Jakov4848/CustomMacroDeck/photos/pic1.jpeg

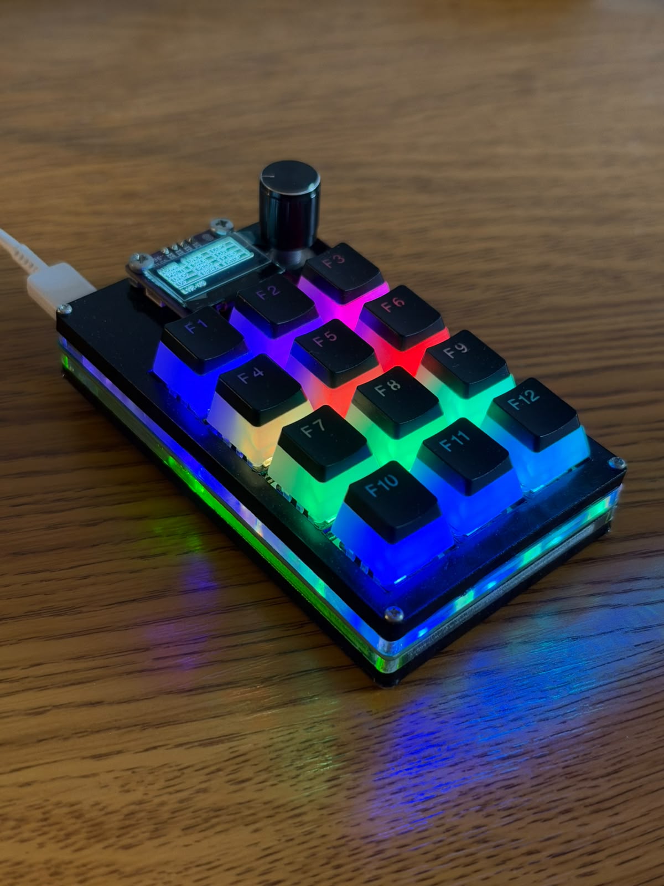
photos/pic1.jpeg
