Jakov4848/CustomMacroDeck/photos/pic2.jpeg

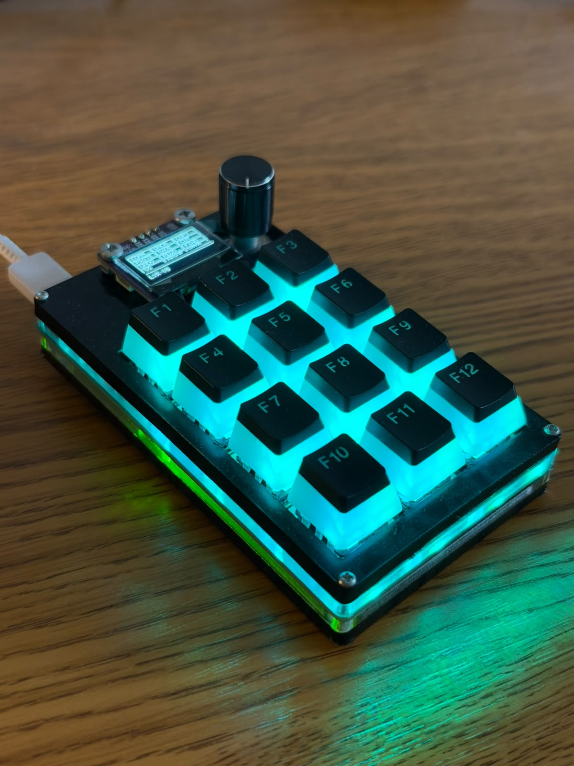
photos/pic2.jpeg
