Jakov4848/CustomMacroDeck/BOM/BOM.ods

PART NUMBER | DESCRIPTION | PACKAGE | DESIGNATOR | QUANTITY | PRICE | MANUFACTURER | URL
ATMEGA32U4-AU | ATmega32U4 mcu | QFP-44(10x10) | U1 | 1 | $ 6.93 | MICROCHIP | https://www.lcsc.com/product-detail/C44854.html?s_z=n_atmega32u4
TYPE-C 16PIN 2MD(073) | USB 2.0 Type‑C Receptacle, 16‑pin, SMT, with through‑hole tabs | SMD | J1 | 1 | $ 1.23 | SHOU HAN | https://www.lcsc.com/product-detail/C2765186.html | +
SSD1306 | Display OLED I2C 0.96 | 30 X 30 | J2 | 1 | €9,95 | SOLDERED | https://soldered.com/products/display-oled-i2c-white-0-96-ssd1306?_pos=1&_psq=ssd1&_ss=e&_v=1.0 | +
Conn_02x03_Top_Bottom | ICSP female header | THT | J3 | 1 |  |  |  | +
TS-1092S-B3D2-G | Tactile Switch | 6.1mmx3.6mm | SW1 | 1 |  |  |  | +
Cherry MX | Mechanical keyswitch | THT |  | 12 | €1,56 | HanElectricity | https://www.lcsc.com/product-detail/C49234236.html?s_z=n_red%2520switch
CPG151101S11-2 | Hot-Swap socket | SMD | SW2-13 | 12 |  | HanElectricity | https://www.lcsc.com/product-detail/C49352235.html?s_z=n_q_CPG151101S11
1N4148W | Diode Independent 75V 150mA Surface Mount | SOD-123 | D1-12 | 12 |  |  |  | +
ORH-B36G | Blue 460nm LED Indication | 0603LED | D13 | 1 |  |  |  | +
NQ03WAF1001T5E | 1kOhm Resistor(1%) | 0603R | R7 | 1 |  |  |  | +
0603WAF2201T5E | 2.2kOhm Resistor(1%) | 0603R | R8 R9 | 2 |  | $ 0.15 |  | +
0603WAF5101T5E | 5.1kOhm Resistor(1%) | 0603R | R1 R2 | 2 |  |  |  | +
FRC0603J103TS | 10kOhm Resistor(5%) | 0603R | R5 R6 | 2 |  |  |  | +
0603WAF4700T5E | 470Ω ±1% 100mW 0603 Thick Film Resistor | 0603R |  |  |  | UNI-ROYAL | https://www.lcsc.com/product-detail/C23179.html?s_z=n_q_0603WAF400T5E
0603WAF220JT5E | 22OHm Resistor(1%) | 0603R | R3 R4 | 2 | $ 0.13 | UNI-ROYAL | https://www.lcsc.com/product-detail/C23345.html?s_z=n_22Ohm%2520resistort
CGA0603XZR104K500JT | 100nF Capacitor(10%) | 0603C | C4 C5 C6 C8 | 6 |  |  |  | +
CGA0805X7R106K250MT | 10uF Capacitor(10%) | 0805C | C7 | 1 |  |  |  | +
CL10B105KA8NNNC | 1uF Capacitor(10%) | 0603C | C1 | 1 |  |  |  | +
CC0603JRNPO9BN220 | 22pF Capacitor(5%) | 0603C | C2 C3 | 2 | $ 0.28 | YAGEO | https://www.lcsc.com/product-detail/C105620.html?s_z=n_22pF
ABM3-16.000MHZ-D2Y-T | Crystal 16MHz ±20ppm 18pF 40Ω SMD5032-2P | SMD5032-2P | Y1 | 1 | $ 0.57 | ABRACON | https://www.lcsc.com/product-detail/C596861.html?s_z=n_Abracon%2520ABM3-16.000MHZ-D2Y-T
EC11E09244BS | Rotary Encoder Switch EC11 | THT | SW14 | 1 | $ 1.87 | ALPSALPINE | https://www.lcsc.com/product-detail/C470742.html?s_z=n_ec11 | +
MBR0520LT1G | Diode 20V 500mA Surface Mount SOD-123 | SOD-123 | F1 | 1 |  | onsemi | https://www.lcsc.com/product-detail/C23848.html
SMD1206P050TF | Polymeric PTC Resettable Fuse 6V 500mA Surface Mount 1206 | 1206D | D14 | 1 |  | PTTC(Polytronics Tech) | https://www.lcsc.com/product-detail/C2836286.html
