Jakov4848/CustomMacroDeck/BOM/LCSC_BOM.csv

LCSC Part Number | Manufacture Part Number | Manufacturer | Customer NO. | Package | Description | RoHS | Quantity | Unit Price(€) | Ext.Price(€) | Estimated lead time (business days) | Updated lead time | Date Code / Lot No. | Status
C49234236 | CPG151101D05 | HanElectricity |  | Through Hole | Red Switch 12V 45gf Through Hole Pushbutton Switches RoHS | YES | 15 | 0.0972 | 1.46 |  |  |  | -
C49352235 | CPG151101S11-2 | HanElectricity |  | - | 5,000 cycles 2 12V 3000gf Pushbutton Switches RoHS | YES | 50 | 0.0397 | 1.99 |  |  |  | -
C44854 | ATMEGA32U4-AU | MICROCHIP |  | QFP-44(10x10) | AVR 8 Bit 16MHz 26 QFP-44(10x10) Microcontrollers RoHS | YES | 4 | 7.0283 | 28.11 |  |  |  | -
C23179 | 0603WAF4700T5E | UNI-ROYAL |  | 0603 | 470Ω ±1% 100mW 0603 Thick Film Resistor | YES | 100 | 0.0015 | 0.15 |  |  |  | -
C23345 | 0603WAF220JT5E | UNI-ROYAL |  | 0603 | 22Ω ±1% 100mW 0603 Thick Film Resistor | YES | 100 | 0.0015 | 0.15 |  |  |  | -
C105620 | CC0603JRNPO9BN220 | YAGEO |  | 0603 | 22pF ±5% 50V Ceramic Capacitor NP0 0603 | YES | 100 | 0.0025 | 0.25 |  |  |  | -
C596861 | ABM3-16.000MHZ-D2Y-T | ABRACON |  | SMD5032-2P | Crystal 16MHz ±20ppm 18pF 40Ω SMD5032-2P | YES | 5 | 0.5294 | 2.65 |  |  |  | -
C470742 | EC11E09244BS | ALPSALPINE |  | Through Hole | Through Hole Encoders RoHS | YES | 2 | 1.6678 | 3.34 |  |  |  | -
C23848 | MBR0520LT1G | onsemi |  | SOD-123 | Diode 20V 500mA Surface Mount SOD-123 | YES | 5 |  |  |  |  |  | Inquiring
C2836286 | SMD1206P050TF | PTTC(Polytronics Tech) |  | 1206 | Polymeric PTC Resettable Fuse 6V 500mA Surface Mount 1206 | YES | 10 | 0.0644 | 0.64 |  |  |  | -
C965555 | WS2812B-2020 | Worldsemi |  | SMD,2.2x2mm | SMD,2.2x2mm LED Addressable, Specialty RoHS | YES | 20 |  |  |  |  |  | Inquiring
C49234235 | CPG151101D13 | HanElectricity |  | Through Hole | Blue Switch 12V 50gf Through Hole Pushbutton Switches RoHS | YES | 15 | 0.0933 | 1.40 |  |  |  | -
C49234237 | CPG151101D06 | HanElectricity |  | Through Hole | Brown Switch 12V 45gf Through Hole Pushbutton Switches RoHS | YES | 15 | 0.0977 | 1.47 |  |  |  | -
C41430893 | CPG151101S11-16 | HanElectricity |  | SMD,14.5x5.9mm | 5,000 cycles 2 12V 3000gf SMD,14.5x5.9mm Pushbutton Switches RoHS | YES | 20 | 0.0386 | 0.77 |  |  |  | -
