Jakov4848/CustomMacroDeck/photos/pcb_soldered1.jpeg

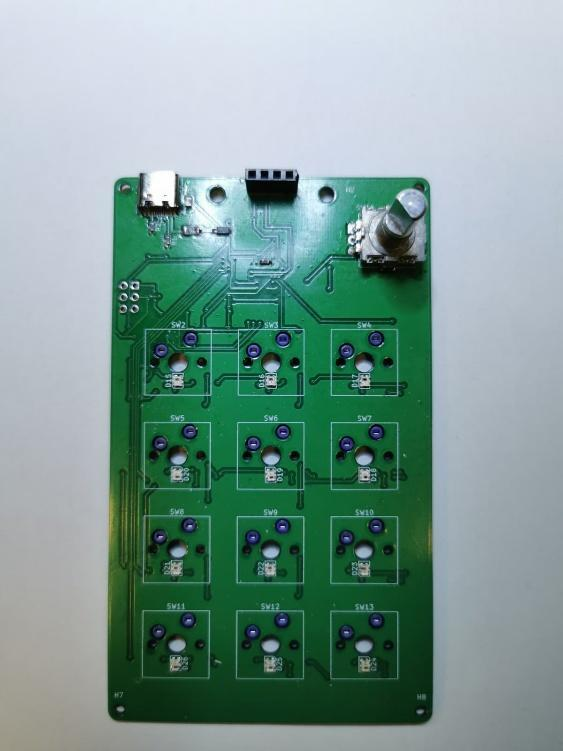
photos/pcb_soldered1.jpeg
