Jakov4848/CustomMacroDeck/photos/pcb_soldered2.png

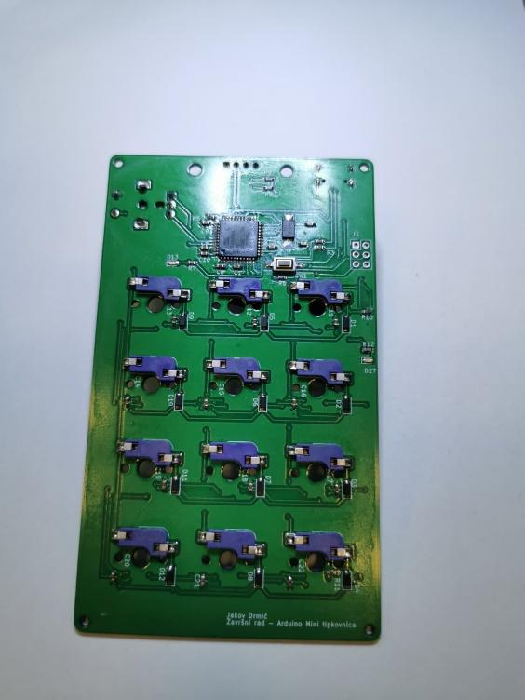
photos/pcb_soldered2.png
