Jakov4848/CustomMacroDeck/kicad_files/macropad.kicad_pcb

## KiCad design kicad_files/macropad.kicad_pcb (2026-10-21)

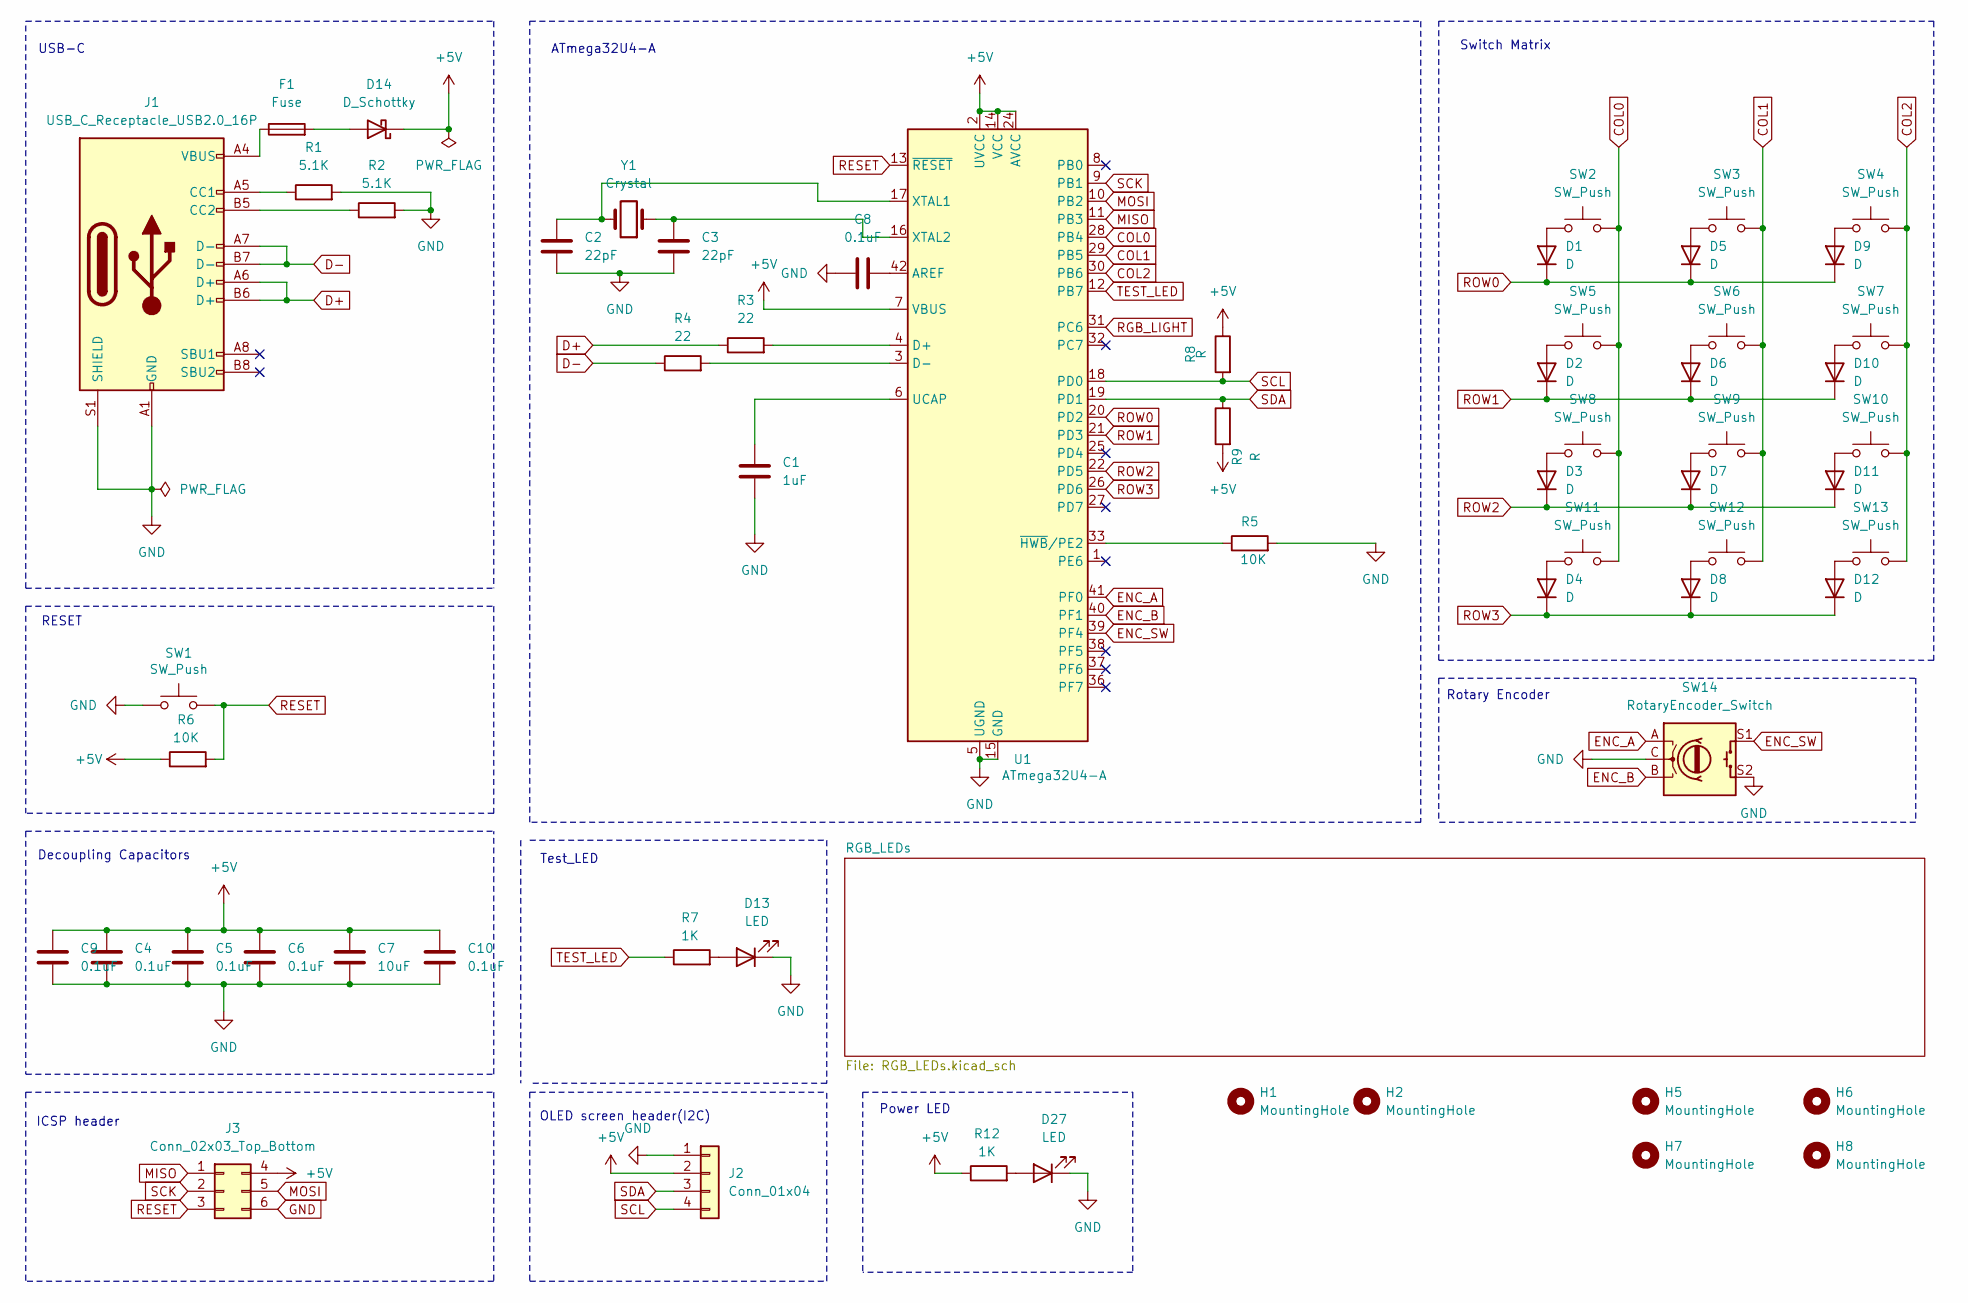
[picture p9: schematic macropad.kicad_sch]

Parts:
C1: 1uF; C_0603_1608Metric_Pad1.08x0.95mm_HandSolder
C2, C3: 22pF; C_0603_1608Metric_Pad1.08x0.95mm_HandSolder
C4, C5, C6, C8, C9, C10: 0.1uF; C_0603_1608Metric_Pad1.08x0.95mm_HandSolder
C7: 10uF; C_0805_2012Metric_Pad1.18x1.45mm_HandSolder
D1, D2, D3, D4, D5, D6, D7, D8, D9, D10, D11, D12: D; D_SOD-123
D13, D27: LED; LED_0603_1608Metric_Pad1.05x0.95mm_HandSolder
D14: D_Schottky; D_SOD-123
F1: Fuse; Fuse_1206_3216Metric_Pad1.42x1.75mm_HandSolder
H1, H2: MountingHole; MountingHole_3.2mm_M3
H5, H6, H7, H8: MountingHole; MountingHole_2.2mm_M2
J1: USB_C_Receptacle_USB2.0_16P; USB_C_Receptacle_HRO_TYPE-C-31-M-12
J2: Conn_01x04; PinSocket_1x04_P2.54mm_Vertical
J3: Conn_02x03_Top_Bottom; PinHeader_2x03_P2.54mm_Vertical
R1, R2: 5.1K; R_0603_1608Metric_Pad0.98x0.95mm_HandSolder
R3, R4: 22; R_0603_1608Metric_Pad0.98x0.95mm_HandSolder
R5, R6: 10K; R_0603_1608Metric_Pad0.98x0.95mm_HandSolder
R7, R12: 1K; R_0603_1608Metric_Pad0.98x0.95mm_HandSolder
R8, R9: R; R_0603_1608Metric_Pad0.98x0.95mm_HandSolder
SW1: SW_Push; SW_SPST_CK_RS282G05A3
SW2, SW3, SW4, SW5, SW6, SW7, SW8, SW9, SW10, SW11, SW12, SW13: SW_Push; SW_Hotswap_Kailh_MX_1.00u
SW14: RotaryEncoder_Switch; RotaryEncoder_Alps_EC11E-Switch_Vertical_H20mm_MountingHoles
U1: ATmega32U4-A; TQFP-44_10x10mm_P0.8mm
Y1: Crystal; Crystal_SMD_Abracon_ABM3-2Pin_5.0x3.2mm_HandSoldering

Connections:
+5V: C4.1, C5.1, C6.1, C7.1, C9.1, C10.1, D14.1 (K), J2.2, J3.4, R6.1, R8.1, R9.2, R12.1, U1.2 (UVCC), U1.7 (VBUS), U1.14 (VCC), U1.24 (AVCC), U1.34 (VCC), U1.44 (AVCC); also elsewhere on the board
COL0: SW2.2, SW5.2, SW8.2, SW11.2, U1.28 (PB4)
COL1: SW3.2, SW6.2, SW9.2, SW12.2, U1.29 (PB5)
COL2: SW4.2, SW7.2, SW10.2, SW13.2, U1.30 (PB6)
D+: J1.A6 (D+), J1.B6 (D+), R3.1
D-: J1.A7 (D-), J1.B7 (D-), R4.1
ENC_A: SW14.A, U1.41 (PF0)
ENC_B: SW14.B, U1.40 (PF1)
ENC_SW: SW14.S1, U1.39 (PF4)
GND: C1.2, C2.2, C3.2, C4.2, C5.2, C6.2, C7.2, C8.1, C9.2, C10.2, D13.1 (K), D27.1 (K), J1.A1 (GND), J1.A12 (GND), J1.B1 (GND), J1.B12 (GND), J1.S1 (SHIELD), J2.1, J3.6, R1.2, R2.2, R5.2, SW1.1, SW14.C, SW14.S2, U1.5 (UGND), U1.15 (GND), U1.23 (GND), U1.35 (GND), U1.43 (GND); also elsewhere on the board
MISO: J3.1, U1.11 (PB3)
MOSI: J3.5, U1.10 (PB2)
unnamed: D1.2 (A), SW2.1
unnamed: D2.2 (A), SW5.1
unnamed: D3.2 (A), SW8.1
unnamed: D4.2 (A), SW11.1
unnamed: D5.2 (A), SW3.1
unnamed: D6.2 (A), SW6.1
unnamed: D7.2 (A), SW9.1
unnamed: D8.2 (A), SW12.1
unnamed: D9.2 (A), SW4.1
unnamed: D10.2 (A), SW7.1
unnamed: D11.2 (A), SW10.1
unnamed: D12.2 (A), SW13.1
unnamed: D13.2 (A), R7.2
unnamed: D14.2 (A), F1.2
unnamed: D27.2 (A), R12.2
unnamed: F1.1, J1.A4 (VBUS), J1.A9 (VBUS), J1.B4 (VBUS), J1.B9 (VBUS)
unnamed: J1.A5 (CC1), R1.1
unnamed: J1.B5 (CC2), R2.1
unnamed: C8.2, U1.42 (AREF)
unnamed: R3.2, U1.4 (D+)
unnamed: R4.2, U1.3 (D-)
unnamed: C1.1, U1.6 (UCAP)
unnamed: C2.1, U1.17 (XTAL1), Y1.2
unnamed: C3.1, U1.16 (XTAL2), Y1.1
unnamed: R5.1, U1.33 (~HWB/PE2)
RESET: J3.3, R6.2, SW1.2, U1.13 (~RESET)
RGB_LIGHT: U1.31 (PC6); also elsewhere on the board
ROW0: D1.1 (K), D5.1 (K), D9.1 (K), U1.20 (PD2)
ROW1: D2.1 (K), D6.1 (K), D10.1 (K), U1.21 (PD3)
ROW2: D3.1 (K), D7.1 (K), D11.1 (K), U1.22 (PD5)
ROW3: D4.1 (K), D8.1 (K), D12.1 (K), U1.26 (PD6)
SCK: J3.2, U1.9 (PB1)
SCL: J2.4, R8.2, U1.18 (PD0)
SDA: J2.3, R9.1, U1.19 (PD1)
TEST_LED: R7.1, U1.12 (PB7)

Notes on the sheet:
RESET
Power LED
Rotary Encoder
ICSP header
Test_LED
Switch Matrix
USB-C
ATmega32U4-A
Decoupling Capacitors
OLED screen header(I2C)

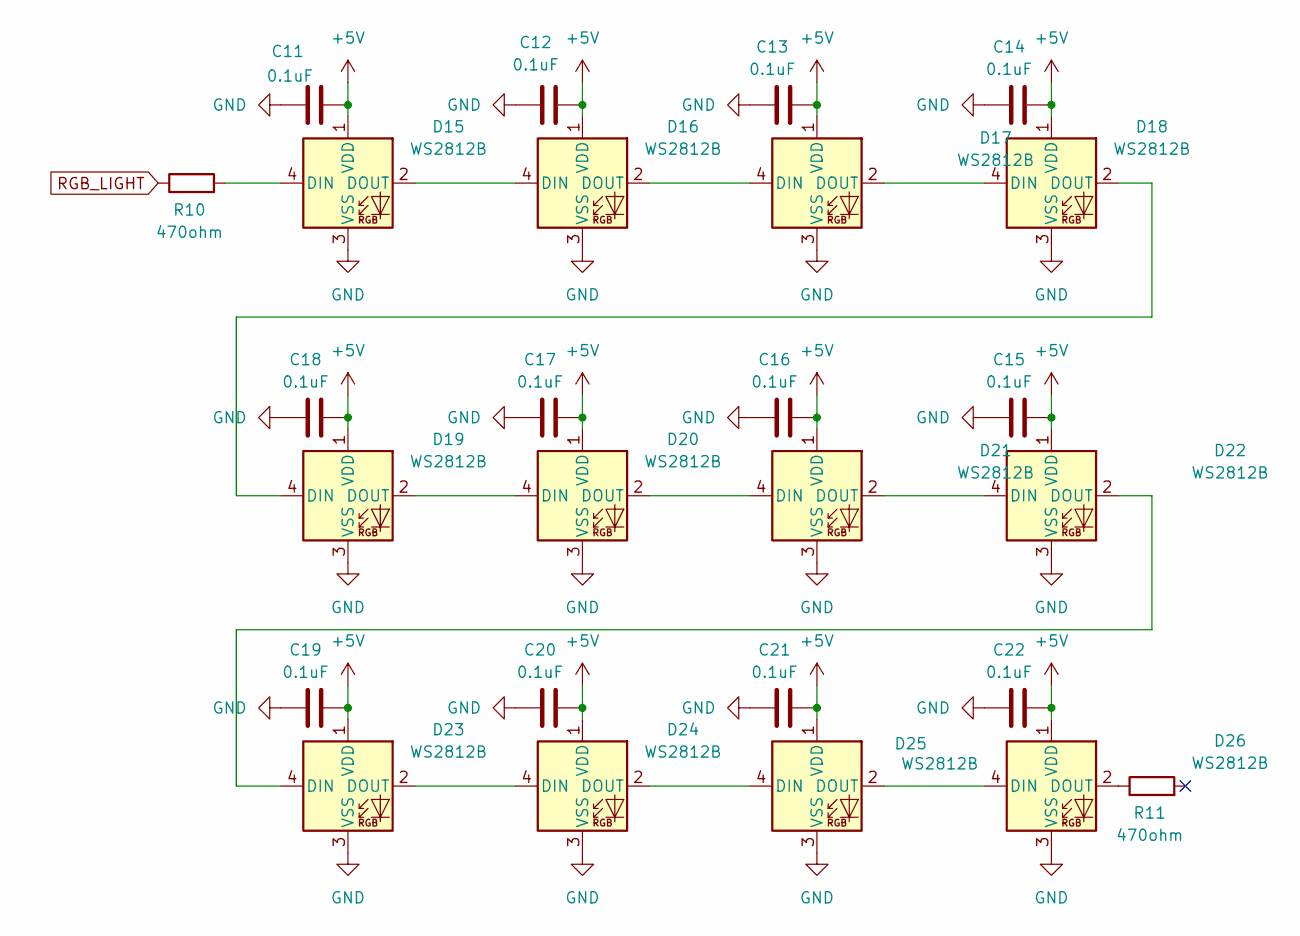
[picture p10: schematic RGB_LEDs.kicad_sch]

Parts:
C11, C12, C13, C14, C15, C16, C17, C18, C19, C20, C21, C22: 0.1uF; C_0603_1608Metric_Pad1.08x0.95mm_HandSolder
D15, D16, D17, D18, D19, D20, D21, D22, D23, D24, D25, D26: WS2812B; LED_WS2812B-2020_PLCC4_2.0x2.0mm
R10, R11: 470ohm; R_0603_1608Metric_Pad0.98x0.95mm_HandSolder

Connections:
+5V: C11.2, C12.2, C13.2, C14.2, C15.2, C16.2, C17.2, C18.2, C19.2, C20.2, C21.2, C22.2, D15.1 (VDD), D16.1 (VDD), D17.1 (VDD), D18.1 (VDD), D19.1 (VDD), D20.1 (VDD), D21.1 (VDD), D22.1 (VDD), D23.1 (VDD), D24.1 (VDD), D25.1 (VDD), D26.1 (VDD); also elsewhere on the board
GND: C11.1, C12.1, C13.1, C14.1, C15.1, C16.1, C17.1, C18.1, C19.1, C20.1, C21.1, C22.1, D15.3 (VSS), D16.3 (VSS), D17.3 (VSS), D18.3 (VSS), D19.3 (VSS), D20.3 (VSS), D21.3 (VSS), D22.3 (VSS), D23.3 (VSS), D24.3 (VSS), D25.3 (VSS), D26.3 (VSS); also elsewhere on the board
unnamed: D15.4 (DIN), R10.2
unnamed: D15.2 (DOUT), D16.4 (DIN)
unnamed: D16.2 (DOUT), D17.4 (DIN)
unnamed: D17.2 (DOUT), D18.4 (DIN)
unnamed: D18.2 (DOUT), D19.4 (DIN)
unnamed: D19.2 (DOUT), D20.4 (DIN)
unnamed: D20.2 (DOUT), D21.4 (DIN)
unnamed: D21.2 (DOUT), D22.4 (DIN)
unnamed: D22.2 (DOUT), D23.4 (DIN)
unnamed: D23.2 (DOUT), D24.4 (DIN)
unnamed: D24.2 (DOUT), D25.4 (DIN)
unnamed: D25.2 (DOUT), D26.4 (DIN)
unnamed: D26.2 (DOUT), R11.1
RGB_LIGHT: R10.1; also elsewhere on the board

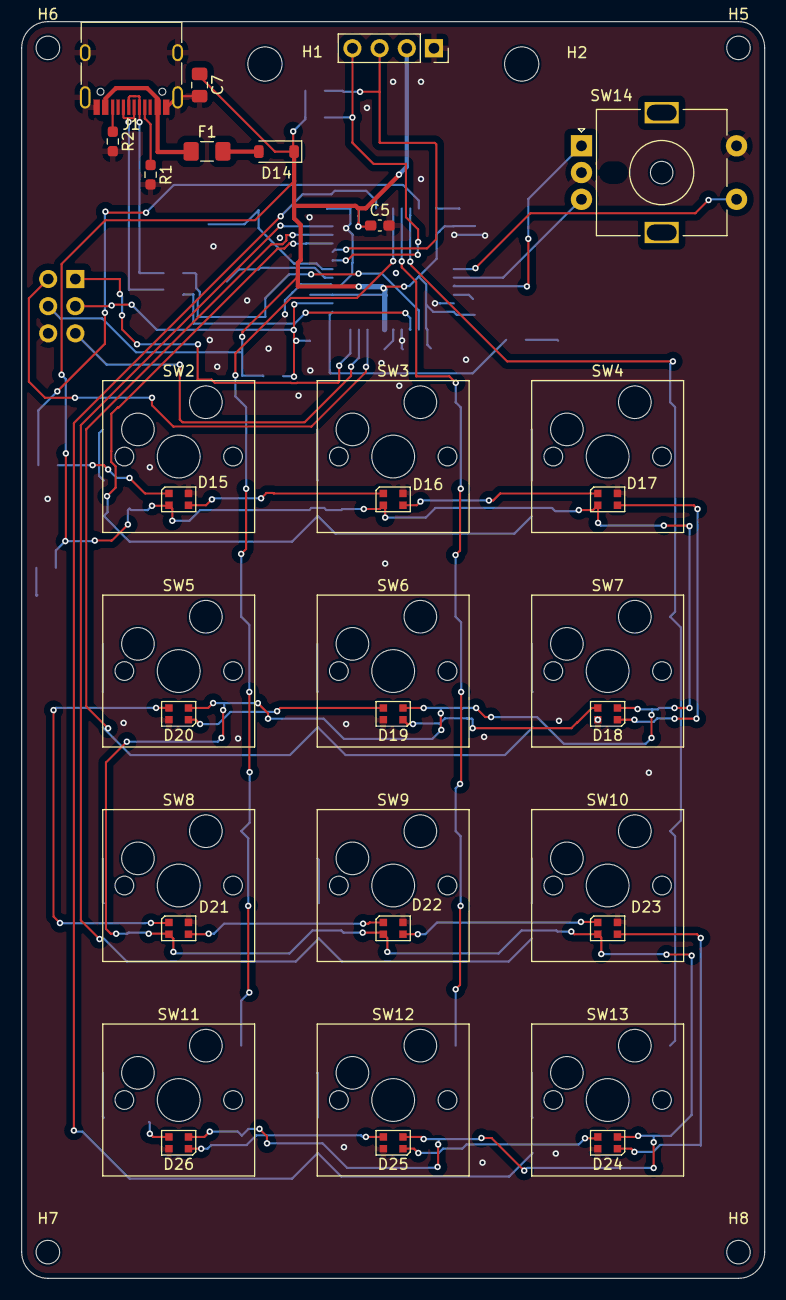
[picture p11: board macropad.kicad_pcb from above]

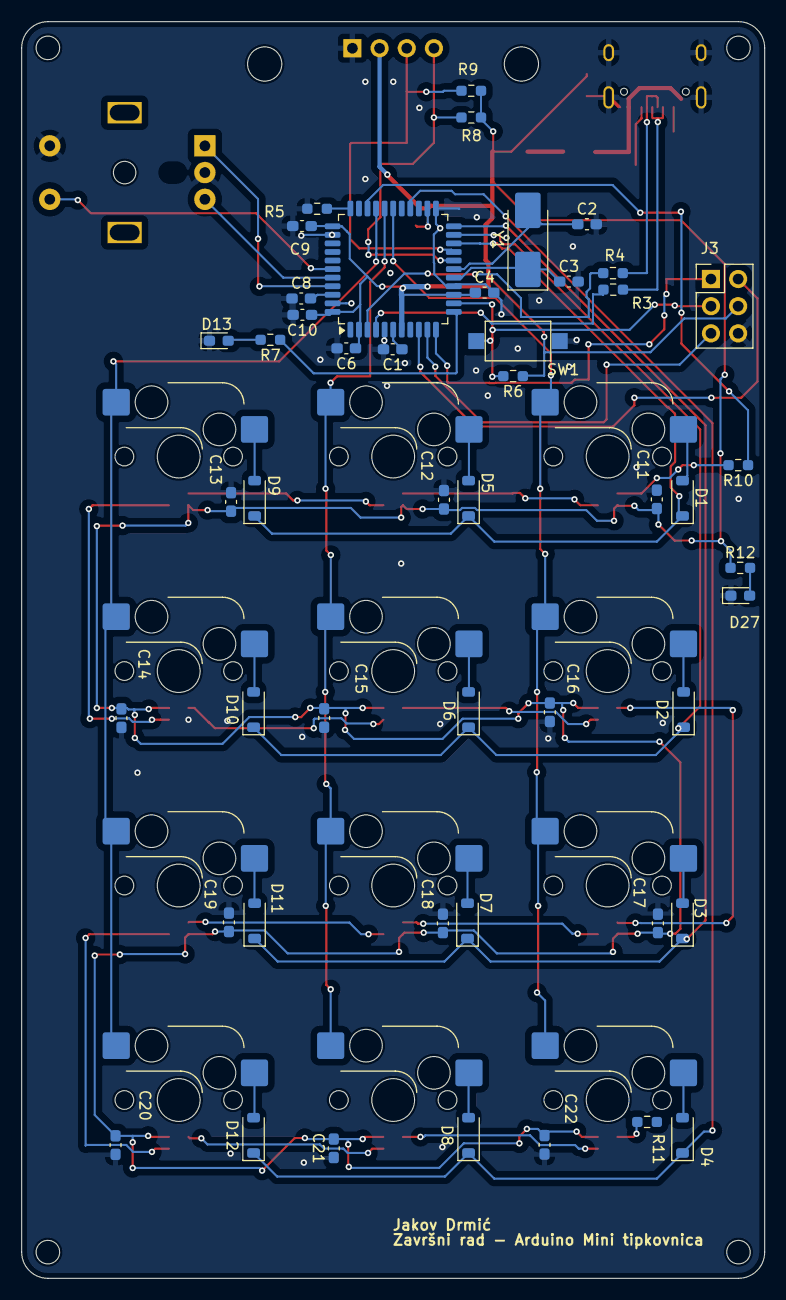
[picture p12: board macropad.kicad_pcb from below]

Board: 2 copper layers, 69.5 x 117.5 mm, 87 parts (48 on the bottom side), 60 nets.
