Jakov4848/CustomMacroDeck/UART_programmer/macropad_config.txt

# --- NAZIVI LAYERA ---
{{0,VS}}
{{1,PSHOP}}
{{2,BROWSER}}

# --- LAYER 0: VScode ---
<<0,0,COMM,[1M1][1k][2k][1c][3]>>
<<0,1,UNCM,[1M1][1k][2k][1u][3]>>
<<0,2,COPY,[1M1][1c][3]>>
<<0,3,PASTE,[1M1][1v][3]>>
<<0,4,SAVE,[1M1][1s][3]>>
<<0,5,CUT,[1M1][1x][3]>>
<<0,6,UNDO,[1M1][1y][3]>>
<<0,7,REDO,[1M1][1y][3]>>
<<0,8,FIND,[1M1][1f][3]>>
<<0,9,FRMAT,[1M2][1M3][1f][3]>>
<<0,10,CMD_P,[1M1][1M2][1p][3]>>
<<0,11,CLOSE,[1M1][1w][3]>>

# --- LAYER 1: PHOTOSHOP ---
<<1,0,BRUSH,[1b][3]>>
<<1,1,ERASE,[1e][3]>>
<<1,2,MOVE,[1v][3]>>
<<1,3,UNDO,[1M1][1y][3]>>
<<1,4,REDO,[1M1][1M2][1z][3]>>
<<1,5,TRNSF,[1M1][1t][3]>>
<<1,6,N_LYR,[1M1][1M2][1n][3]>>
<<1,7,MERGE,[1M1][1e][3]>>
<<1,8,DESEL,[1M1][1d][3]>>
<<1,9,INVRT,[1M1][1i][3]>>
<<1,10,S_WEB,[1M1][1M2][1M3][1s][3]>>
<<1,11,CLOSE,[1M1][1w][3]>>

# --- LAYER 2: BROWSER ---
<<2,0,TAB+,[1M1][1t][3]>>
<<2,1,TAB-,[1M1][1w][3]>>
<<2,2,O_TAB,[1M1][1M2][1t][3]>>
<<2,3,HSTRY,[1M1][1h][3]>>
<<2,4,DWNLD,[1M1][1j][3]>>
<<2,5,BKMK,[1M1][1d][3]>>
<<2,6,ZOOM+,[1M1][1+][3]>>
<<2,7,ZOOM-,[1M1][1-][3]>>
<<2,8,RESET,[1M1][10][3]>>
<<2,9,FIND,[1M1][1f][3]>>
<<2,10,PRINT,[1M1][1p][3]>>
<<2,11,GHOST,[1M1][1M2][1n][3]>>
